industrial-optimization-group/DesdeoInterface/doc/Schematics/README.md

Project files: [link](https://oshwlab.com/amznit/physical_interface_v1-0#P2)

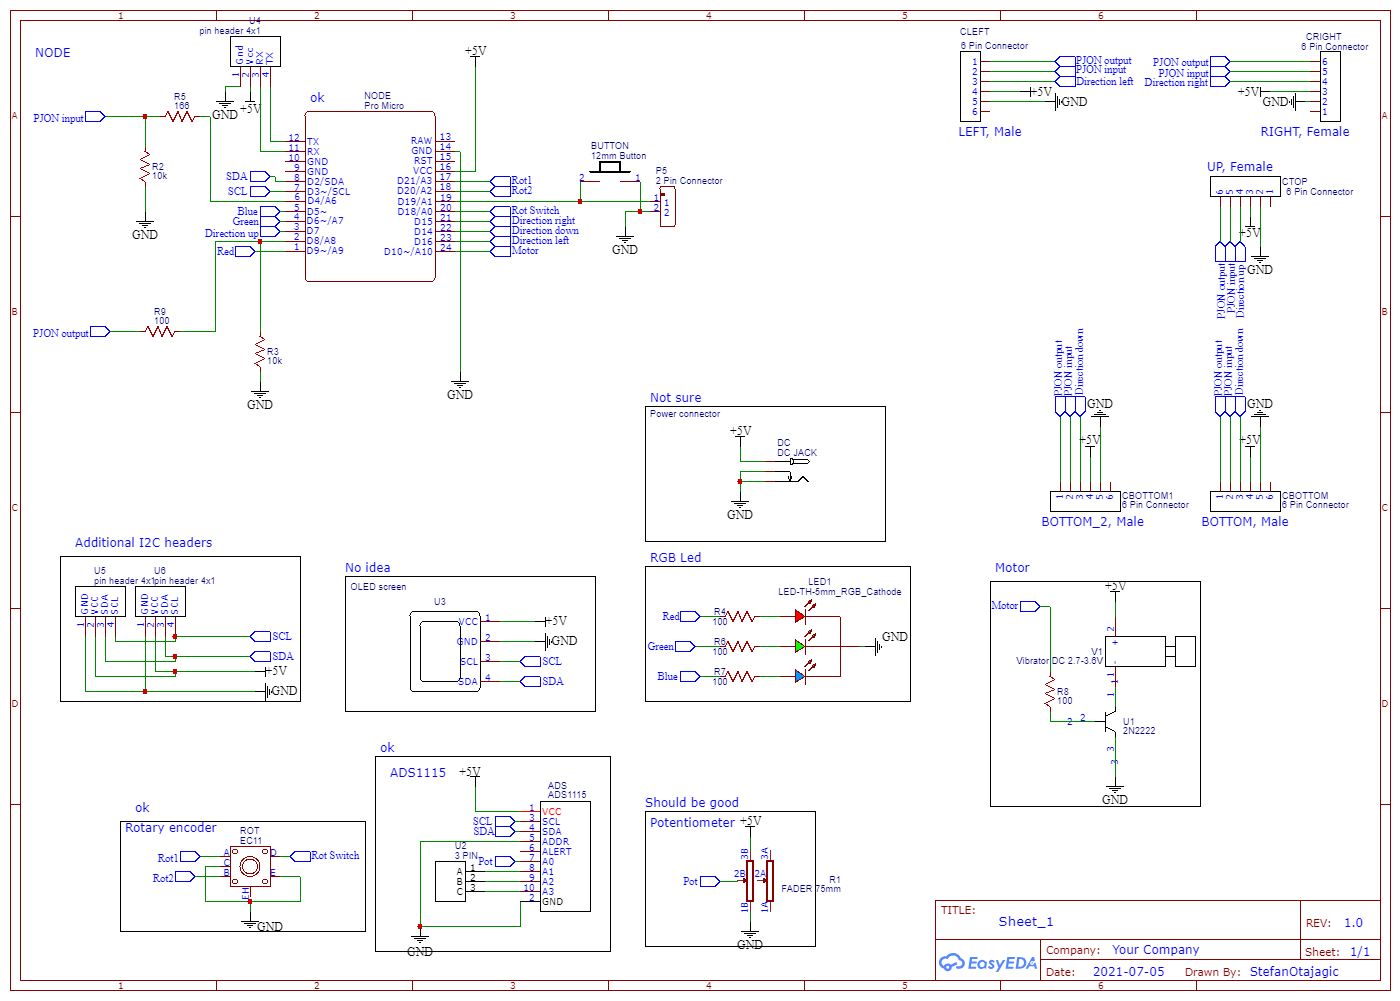
[picture p2: doc/Schematics/schematic_v1.png]
Schematic


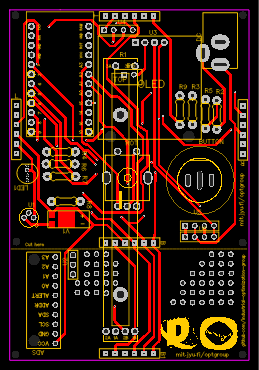
[picture p3: doc/Schematics/pcb_v1.png]
pcb


Notice that the pcb has a 'cut here' line: The pcb can be either 60 or 90mm depending on the components. Currently 90mm is only used for the sliding potentiometer + ads combo.
