industrial-optimization-group/DesdeoInterface/doc/NodeTypes/README.md

Each node has a some type (uint8_t) which we call 'NodeType'. The type is send to the master
and from there to Serial in the configuration state. This allows identification of each node: We can determine what kind of components a node has and the count of these components.

A nodes type can be changed at any point with the 'F' Serial command which takes a 'nodeType' as an argument, see [PacketIds](../PacketIds) for further details on different commands. 

| NodeType | type | explanation |
| --- | --- | --- |
| 0 | Empty | Has nothing |
| 1 | Simple button | Has only a button |
| 2 | Simple potentiometer | Has only a potentiometer|
| 3 | Simple rotary encoder| Has only a rotary encoder, a rotary encoder also has a switch builtin |
| 4 | Potentiometer + Button | Has a potentiometer and a button |
| 5 | rotary encoder + Button | Has a rotary encoder and a button |

This is needed because we are using the same code for each node => To avoid sending readings of floating pins etc we tell each node
which pins should be read/monitored. 
Because of this each component must always be in the same pin(s) meaning that the component pins are predetermined: see [Schematics](../Schematics) for further details. 

A drawback to this (at least for the moment) is that adding new types means that we have to add them to the datatypes.h file AND to the other side of the Serial port.
One way to tackle this would be to have some file for each type: This might be more complicated than what is sounds...
OR read the pin values of each component to see if they are floating or correct (i.e should be low but is high). Might get complicated with more complex components such as screens.
