industrial-optimization-group/DesdeoInterface/desdeo_interface/ArduinoFiles/README.md

# Arduino sketches and libraries

Currently I am moving these files to arduino/libraries but it should be possible to import these to the main sketch with relative imports.
