industrial-optimization-group/DesdeoInterface/desdeo_interface/Examples/README.md

These examples were used in the meeting we had in summer 21 in Naissaari. 
Currently these are obsolete and will be moved to the obsolete folder soon.
