industrial-optimization-group/DesdeoInterface/doc/Diagram.png

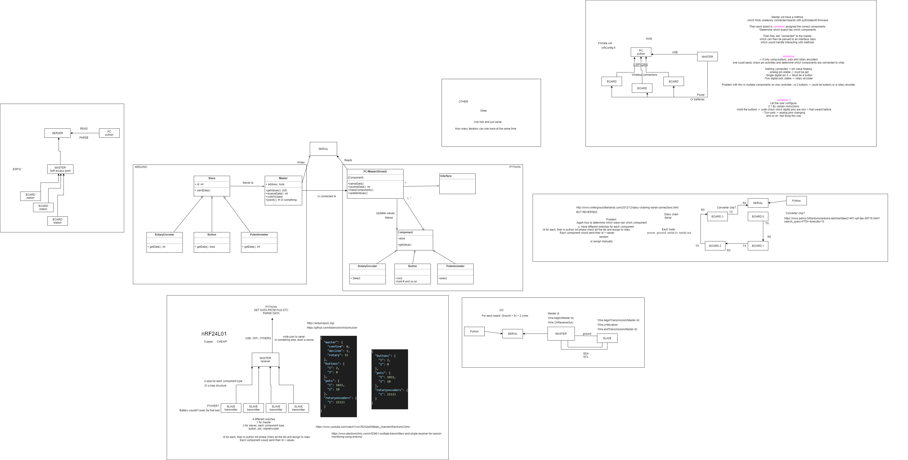
doc/Diagram.png
