industrial-optimization-group/DesdeoInterface/doc/DirectionPins/FlowchartPositions.png

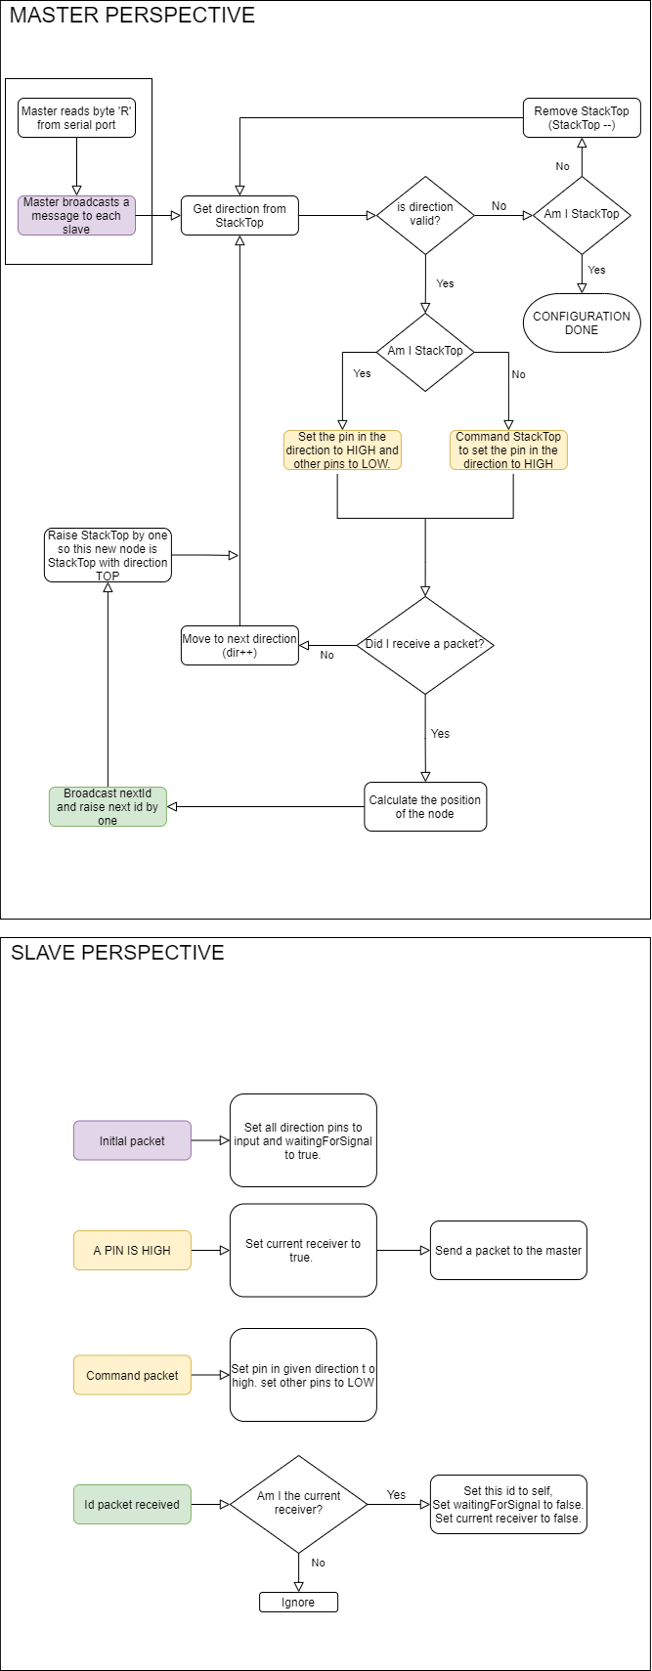
doc/DirectionPins/FlowchartPositions.png
