industrial-optimization-group/DesdeoInterface/doc/Example/Configuration.png

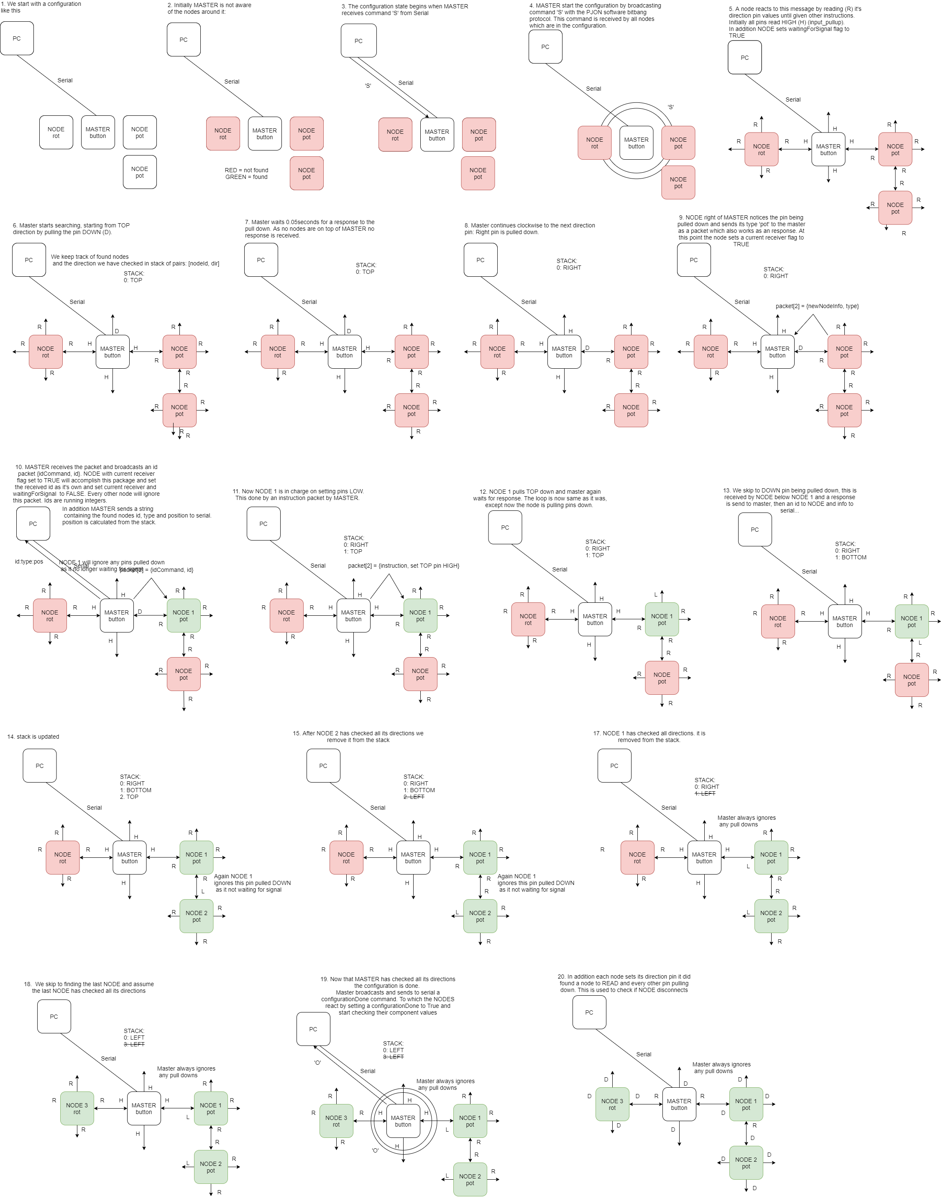
doc/Example/Configuration.png
