industrial-optimization-group/DesdeoInterface/doc/Example/NodeConnection.png

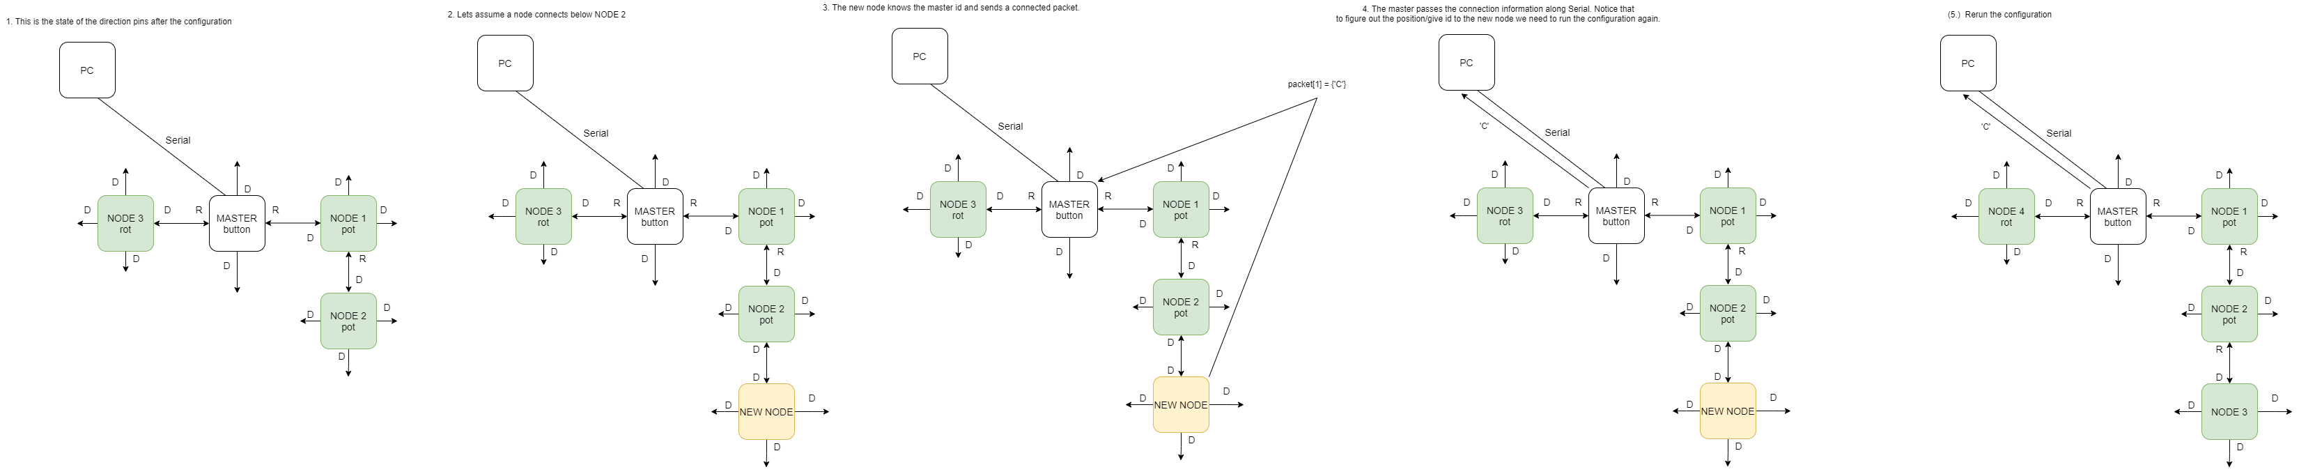
doc/Example/NodeConnection.png
