industrial-optimization-group/DesdeoInterface/doc/Example/NodeDisconnection.png

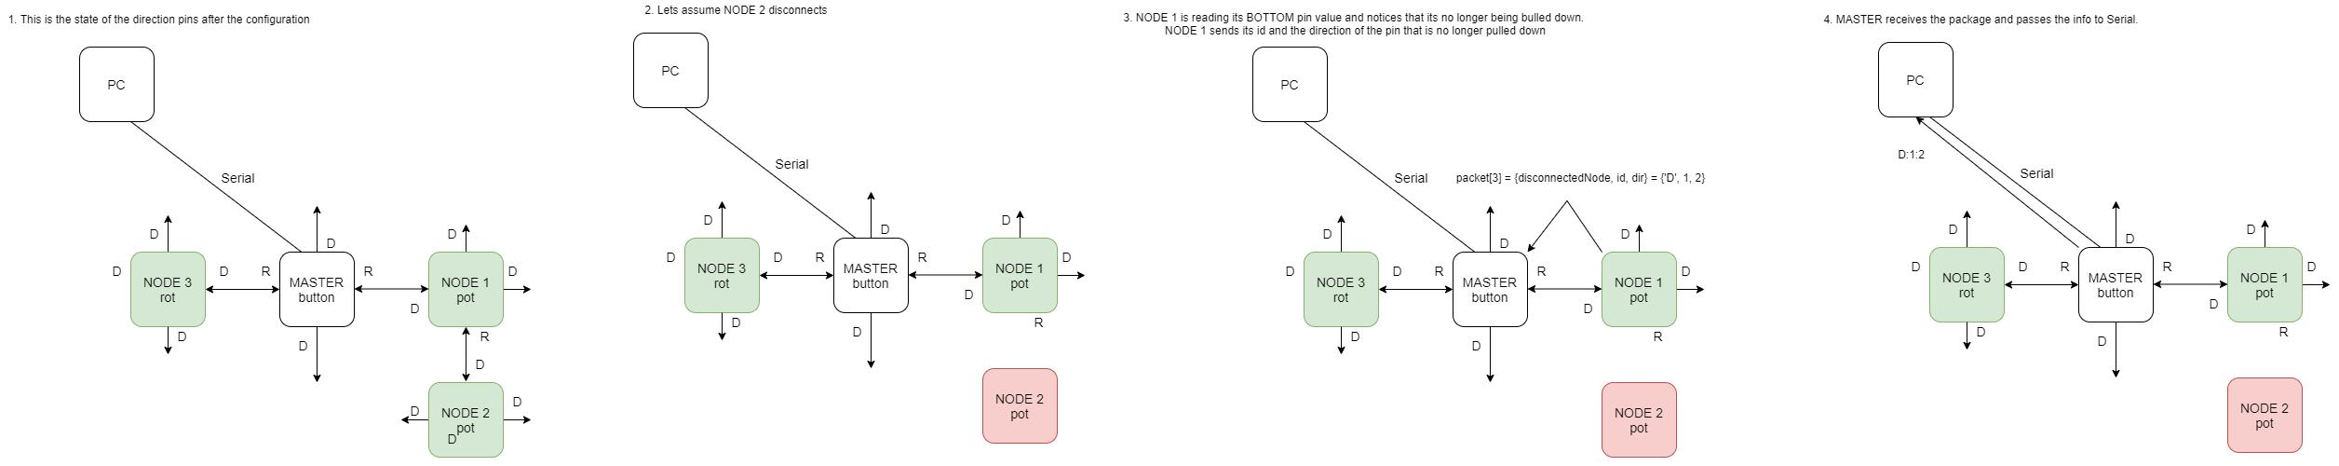
doc/Example/NodeDisconnection.png
