industrial-optimization-group/DesdeoInterface/Sketches/bbReceiver/bbReceiver.ino

#include "RotaryEncoder.h"
#include <PJONSoftwareBitBang.h>
#include <ArduinoJson.h>

PJONSoftwareBitBang bus(0);
StaticJsonDocument<512> doc; //512 is the RAM allocated to this document.
JsonArray rotary = doc["master"].createNestedArray("Rotary");
int buttons[2] = {2, 3};
//RotaryEncoder rotEncoder = RotaryEncoder(8,9);
int rotaryEncoder[2] = {8,9};

void receiver_function(uint8_t *payload, uint16_t length, const PJON_Packet_Info &packet_info) {
  /* Make use of the payload before sending something, the buffer where payload points to is
     overwritten when a new message is dispatched */
     String t;
     t += char(payload[0]);
     uint8_t id = (uint8_t)(payload[1]);
     uint16_t value = 0;
    if (t == "B") {
      //Serial.print("Button ID: ");
      //Serial.print(id);
      value = (uint16_t)(payload[2]);
      //Serial.print(". Value: ");
      //Serial.println(value);
    }
    else if (t == "P") {
      //Serial.print("Potentiometer ID: ");
      //Serial.print(id);
      value = ((uint16_t)(payload[2] << 8) | (uint16_t)(payload[3] & 0xFF));
      //Serial.print(". Value: ");
      //Serial.println(value);
    }
  doc[t][String(id)] = value;
  serializeJson(doc, Serial);
  Serial.println();
};

bool changed() {
return false;
};

void setup() {
  bus.strategy.set_pin(12);
  bus.begin();
  bus.set_receiver(receiver_function);
  pinMode(buttons[0], INPUT);
  pinMode(buttons[1], INPUT);
  Serial.begin(9600);
};

void loop() {
  int bpin1 = digitalRead(buttons[0]);
  int bpin2 = digitalRead(buttons[1]);
  
  int rot1 = digitalRead(rotaryEncoder[0]);
  int rot2 = digitalRead(rotaryEncoder[1]);

  rotary[0] = rot1;
  rotary[1] = rot2;

  doc["master"]["Accept"] = bpin1;
  doc["master"]["Decline"] = bpin2;
  bus.receive(1000);
};
