industrial-optimization-group/DesdeoInterface/(commit log)

2021-05-11 Arduino info to readme
2021-05-11 moved prev value from pot to button
2021-05-11 Button refining
    1. Added double click functionality
    2. Improved click handling, no more accidental double clicks or debouncing, i hope
    3. Improved holding, hold_time seems to also work. measured with a stop watch.
    4. Added more testing to main
2021-05-12 Modified component class
    1. changed pin to pins as some components require multiple pins
    2. Because of 1. had to modify button and potentiometer classes
    3. Started working on rotary encoder *Don't have the actual component quite yet
2021-05-12 Started working on webusb
    Trying to get a slider web element to work with arduinos potentiometer, one problem, arduino UNO isn't supported
    [Button.py, Potentiometer.py]
2021-05-14 Rotary encoder stuff and interface comments
2021-05-17 Working on rotary encoder module
2021-05-18 Finding problems with button and ideas to overcome them. Also updates on readme
    [Button.py]
2021-05-18 More updates on readme and list -> List, also action method to button
    Haven't tested action method
2021-05-21 Rotary encoder
    Needs some improvents with delays, and dynamic values
2021-05-21 Arduino files, master component started
2021-05-24 Removed not needed files from JS folder and added a button to example as well
2021-05-28 See description
    Ideas on connecting, still kinda difficult, most ways seem to need a id of somesort and then there's also connecting to python and determining components
    Trying things with master component and interfaces
    Added master and slave test ino files to arduinofiles folder, noticed that my leonardo has some driver issue (has to do with the webusb stuff) so testing is a bit difficult atm
    Removed some old comments
    [Master.py, RotaryEncoder.py, webusb.ino]
2021-06-01 Updated diagram
    liking the nrf way or just i2c with multiple sketches with ids
2021-06-03 Testing if stuff works
    Sending data with PJON bitbang protocol works fine. Arduinojson library seems quite nice, might be helpful. Reading data to python through serial works good
2021-06-07 Multiple devices at the sametime with one usb
    Reading data wit a thread from serial. Thread is temporary as it only 'works' when other code is waiting
2021-06-08 RPM example without pyfirmata and with multiple boards
    The code isnt pretty by any means but it's just a proof of consept sort of thing
2021-06-08 rearranging files. simple classes for components arduino side. Rotaryslave
2021-06-11 Two wire communication
2021-06-16 Fixed some delay issues on arduino side. Data is sent to master only when master starts or values change
    [Master.ino, SerialReader.py, Slave.ino]
2021-06-17 Potentiometer values in arduino are now uint16_t instead of an array of both pin values
    Because of the change some changes were needed in the python files
2021-06-17 Copied test cases from interface classes to own folder 'examples', made a quick pareto navigator interface
    Fixed most of the bugs which were caused from moving from pyfiramta to more of an own implementation
    [Master.py, Potentiometer.py, RotaryEncoder.py, nautilusExample.py, nimbusExample.py]
2021-07-08 Buttons to input_pullup
2021-07-09 changed component value datatype to double, added converting to rot and pot, master can send boundsinfo to a node and a node can receive it and assign the bounds to a component
    Problem with packet ids as I am sending a struct for the bounds which doesnt have a id... Now the receiver function is just an if else id == reset and else if the struct. The problem is that you can still read the id from the struct which can give some unwanted results. I will fix this next.
    [Master.ino, Potentiometer.cpp, Potentiometer.h, RotaryEncoder.cpp, RotaryEncoder.h]
2021-07-19 led component, a quick mockup on interface selection screen
2021-07-26 Rotary encoders update values with interrupts
2021-08-12 Added pcb and updated schematic
2021-08-19 added one wire pjon option and more types. Documented pcb problems. and updated react files
    [Datatypes.h, Potentiometer.cpp, UniversalNode.ino]
2021-08-29 fixed a bug with the led colors
    [UniversalNode.ino]
